ProfHindsight/Project-Temp-Sensor-Hardware/Requirements.docx

Requirements:

1. Monitor 1-4 temperature/humidity sensors
2. Bluetooth/802.15.4 device
3. Coin cell powered device
4. Low power consumption

Stretch Goals:

1. Micro USB powerable
2. 2.0V regulator for increased efficiency and 1.
3. External temperature sensor (for a freezer)
4. Buzzer/Speaker
5. Microphone
