ProfHindsight/Project-Temp-Sensor-Hardware/BOM.xlsx

Sheet: V1.0
Vanilla Board
Description | Part Number | Ref | Unit Cost | Quantity | Total | Quantity (x3)
Pressure Sensor | 828-1064-1-ND | IC3 | 3.48 | 1 | 3.48 | 3
Temp and Humidity Sensor | 336-3138-5-ND | IC2 | 2.6 | 1 | 2.6 | 3
Coin Cell Neg Contact | 36-2993-ND | H1 | 0.16 | 1 | 0.16 | 3
Coin Cell Retainer | BC-2003-ND | U1 | 0.33 | 1 | 0.33 | 3
Pushbutton | EG4620CT-ND | U2 | 0.19 | 1 | 0.19 | 3
Gecko MCU | 914-1032-1-ND | IC1 | 1.64 | 1 | 1.64 | 3
Small Decouple | 490-1318-1-ND | C3, C4, C5 | 0.1 | 3 | 0.3 | 9
Buzzer | 433-1027-ND | P5 | 0.59 | 1 | 0.59 | 3
NRF24L | NRF24L01 | P2 | 1.12 | 1 | 0.59 | 3
Decouple Cap | 490-1319-1-ND | C1, C2, C6, C7 | 0.1 | 4 | 0.4 | 12
I2C Resistors | 311-4.7KJRCT-ND | R1, R2 | 0.1 | 2 | 0.2 | 6
 |  |  |  |  | 0
Total |  |  |  |  | 10.48
 |  |  |  |  |  |  | `

Sheet: V2.0
USB Powerable
Description | Part Number | Ref | Unit Cost | Quantity | Total | Quantity (x3)
Pressure Sensor | 828-1064-1-ND | IC3 | 3.48 | 1 | 3.48 | 3
Temp and Humidity Sensor | 336-3138-5-ND | IC2 | 2.6 | 1 | 2.6 | 3
Coin Cell Neg Contact | 36-2993-ND | H1 | 0.16 | 1 | 0.16 | 3
Coin Cell Retainer | BC-2003-ND | U1 | 0.33 | 1 | 0.33 | 3
Micro USB Port | 609-4613-1-ND | P4 | 0.46 | 1 | 0.46 | 3
Ideal Diode | MAX40200AUK+TCT-ND | IC4 | 0.62 | 1 | 0.62 | 3
2.0V Regulator | 893-1172-1-ND | U3 | 1.24 | 1 | 1.24 | 3
Gecko MCU | 914-1092-1-ND | IC1 | 1.26 | 1 | 1.26 | 3
Small Decouple | 490-1318-1-ND | C3, C4, C5 | 0.1 | 3 | 0.3 | 9
2.0V Input Cap | 490-5915-1-ND | C8 | 0.16 | 1 | 0.16 | 3
2.0V Output Cap | 490-10693-1-ND | C9 | 0.13 | 1 | 0.13 | 3
Buzzer | 433-1027-ND | P5 | 0.59 | 1 | 0.59 | 3
Decouple Cap | 490-1319-1-ND | C1, C2, C6, C7 | 0.1 | 4 | 0.4 | 12
Feedforward Cap | 490-5951-1-ND | C10 | 0.1 | 1 | 0.1 | 3
10M Res | 311-10.0MLRCT-ND | R3 | 0.1 | 1 | 0.1 | 3
600k Res | YAG3192CT-ND | R4 | 0.1 | 1 | 0.1 | 3
400k Res | YAG3143CT-ND | R5 | 0.1 | 1 | 0.1 | 3
300k Res | YAG3108CT-ND | R6 | 0.1 | 1 | 0.1 | 3
200k Res | YAG3024CT-ND | R7 | 0.1 | 1 | 0.1 | 3
I2C Resistors | 311-4.7KJRCT-ND | R1, R2 | 0.1 | 2 | 0.2 | 6
NRF24L | NRF24L01 | P2 | 1.12 | 1 | 0.59 | 3
 |  |  |  |  | 0 | 0
Total |  |  |  |  | 13.12

Sheet: Daughterboard
Daughterboard
Description | Part Number | Ref | Unit Cost | Quantity | Total | Quantity (x3)
4-conductor ribbon cable | WM04-06A-ND |  | 0.66 | 1 | 0.66 | 3
 |  |  |  |  |  | 0
Total |  |  |  |  | 0.66
