ProfHindsight/Project-Temp-Sensor-Hardware/WirelessTempSensorV2.0/WirelessTempSensorV2.0.pdf

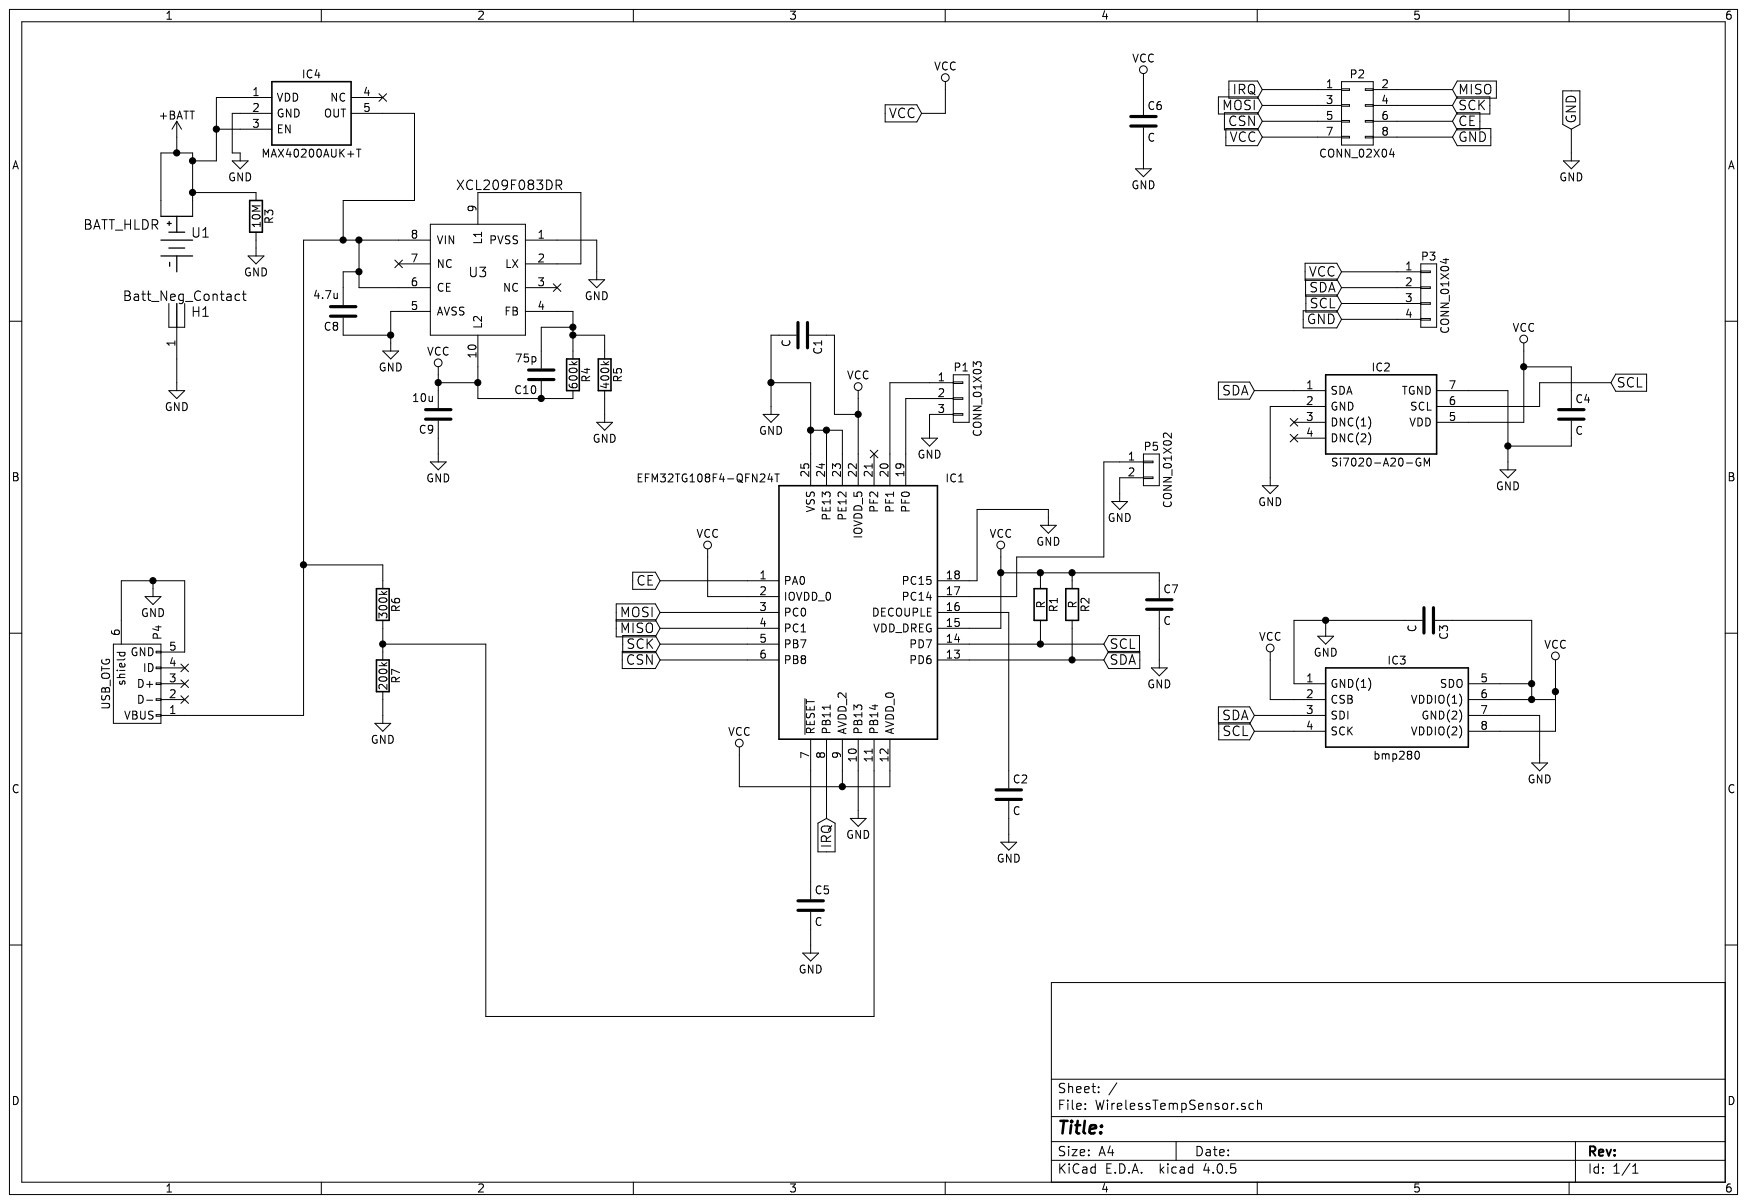
[picture p1: page 1]
