ProfHindsight/Project-Temp-Sensor-Hardware/WirelessTempSensorV1.0/WirelessTempSensorV1.0.pdf

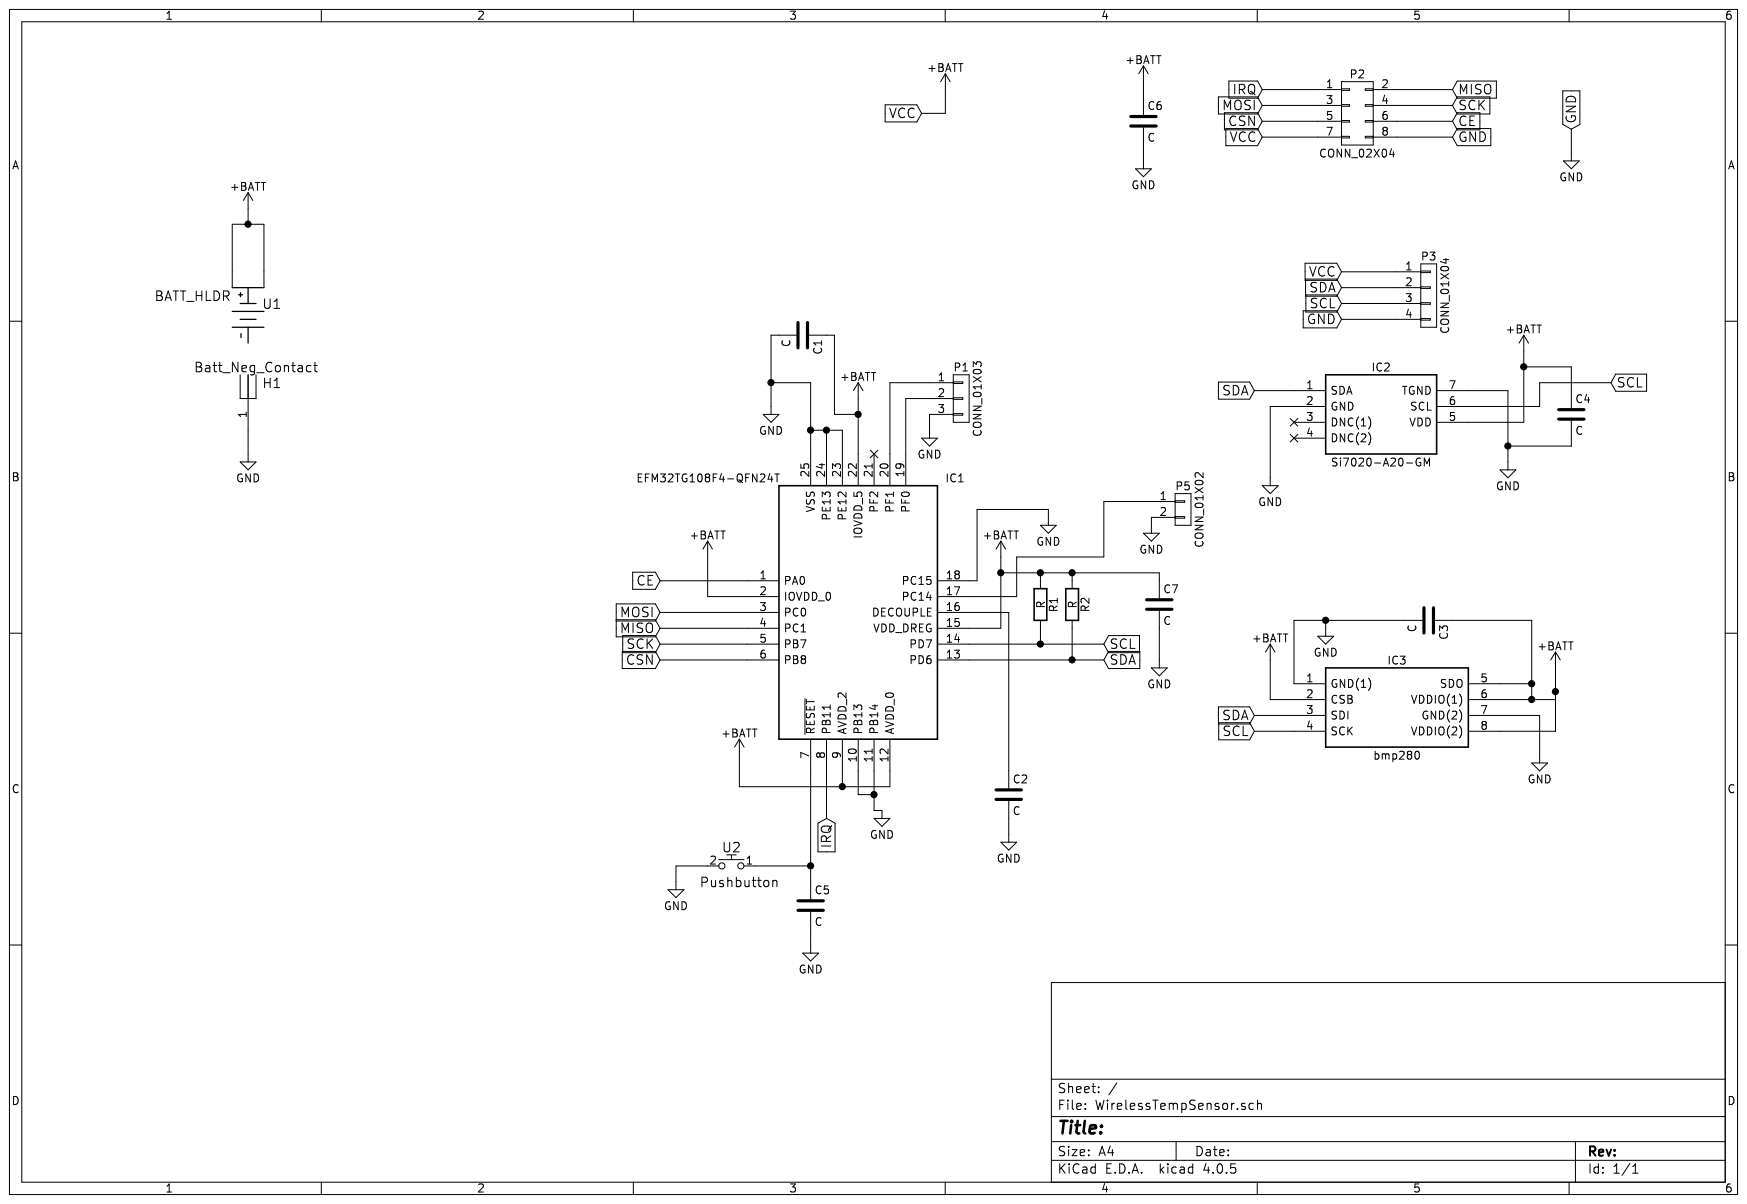
[picture p2: page 1]
