ProfHindsight/Project-Temp-Sensor-Hardware/WirelessTempSensorV1.0/WirelessTempSensor/WirelessTempSensor.kicad_pcb

## KiCad design WirelessTempSensorV1.0/WirelessTempSensor/WirelessTempSensor.kicad_pcb (2018-09-09, an earlier design)

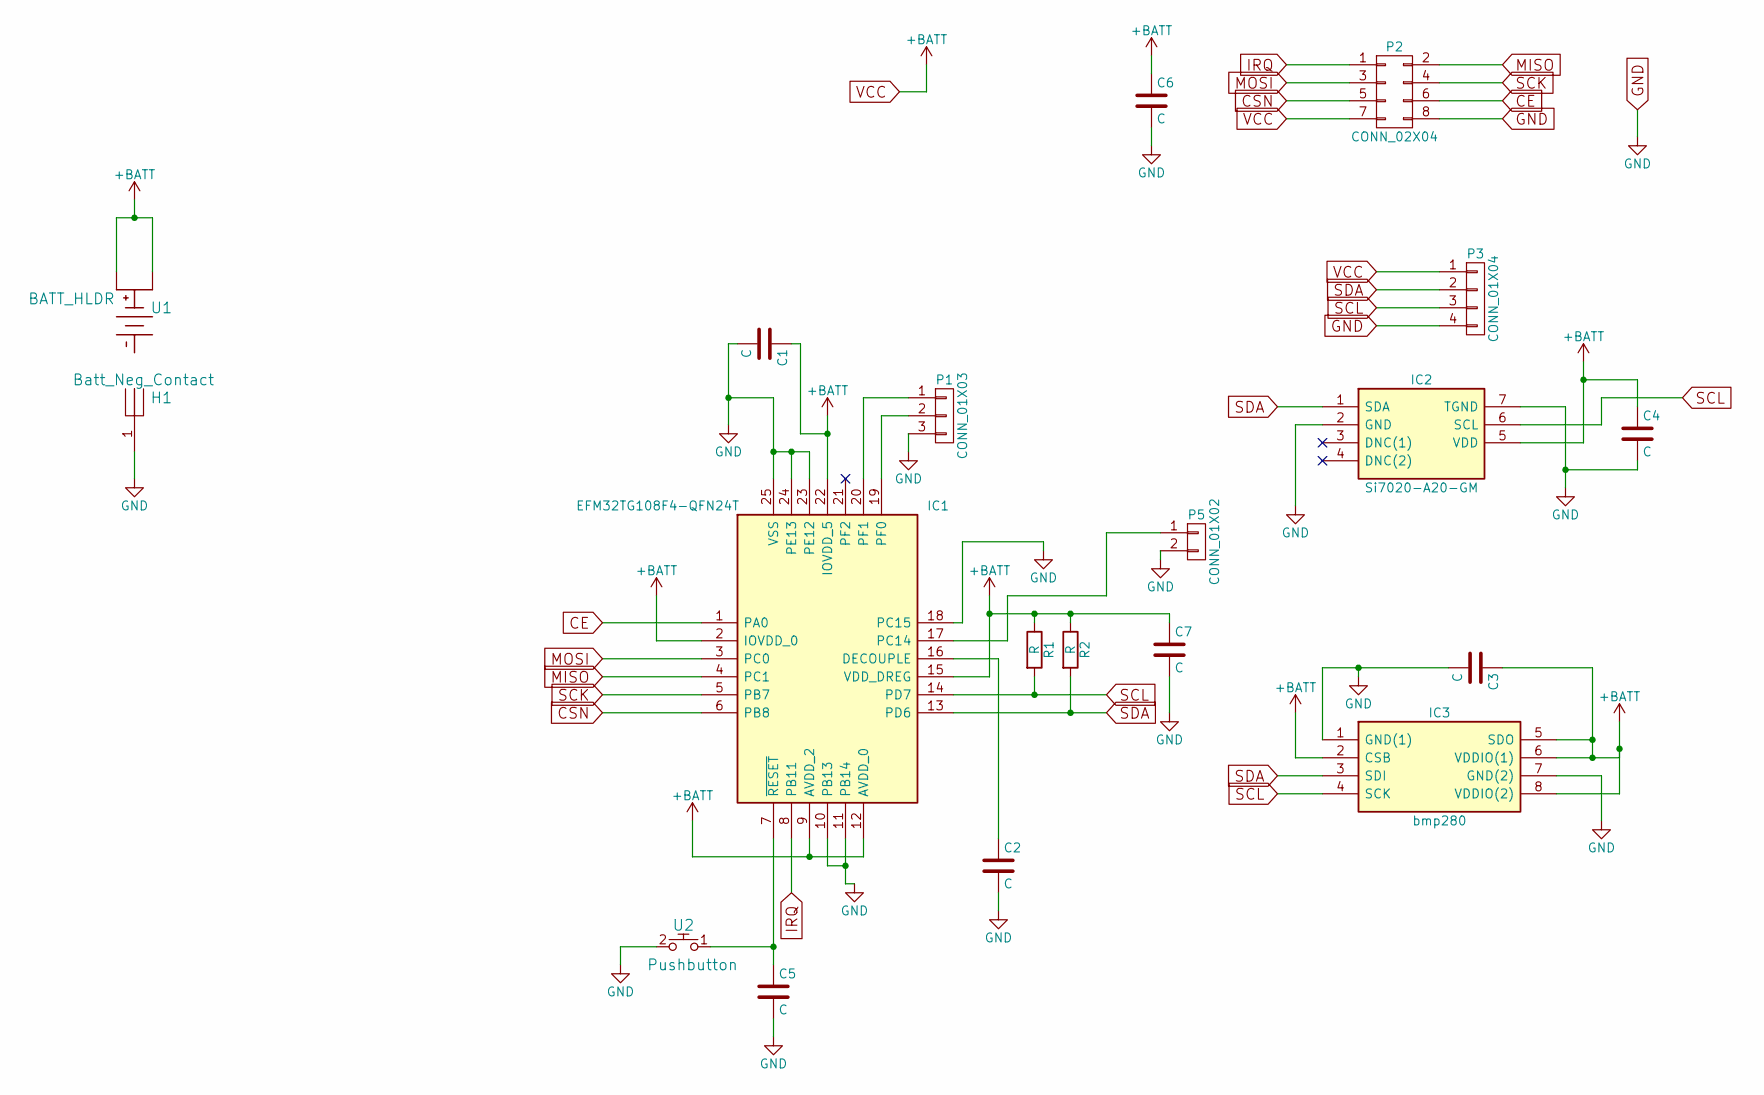
[picture p3: schematic WirelessTempSensor.sch]

Parts:
C1, C2, C3, C4, C5, C6, C7: C; C_0402
H1: Batt_Neg_Contact
IC1: EFM32TG108F4-QFN24T; QFN65P500X500X90-25N; Manufacturer_Part_Number EFM32TG108F4-QFN24T
IC2: Si7020-A20-GM; SON100P300X300X80-7N; Manufacturer_Part_Number Si7020-A20-GM
IC3: bmp280; 8-PIN-METAL-LID-LGA; Manufacturer_Part_Number bmp280
P1: CONN_01X03; Conn_1x3_SMD
P2: CONN_02X04; SDL-108-X-XX_2x04
P3: CONN_01X04; Conn_1x4_SMD
P5: CONN_01X02; Conn_1x2_SMD
R1, R2: R; R_0402
U1: BATT_HLDR; BAT-HLD-001
U2: Pushbutton; PB-P010336

Connections:
CE: IC1.1 (PA0), P2.6
CSN: IC1.6 (PB8), P2.5
GND: C1.2, C2.2, C3.2, C4.2, C5.2, C6.2, C7.2, H1.1, IC1.10 (PB13), IC1.11 (PB14), IC1.18 (PC15), IC1.23 (PE12), IC1.24 (PE13), IC1.25 (VSS), IC2.2 (GND), IC2.7 (TGND), IC3.1 (GND(1)), IC3.7 (GND(2)), P1.3, P2.8, P3.4, P5.2, U2.2
IRQ: IC1.8 (PB11), P2.1
MISO: IC1.4 (PC1), P2.2
MOSI: IC1.3 (PC0), P2.3
unnamed: C2.1, IC1.16 (DECOUPLE)
unnamed: C5.1, IC1.7 (~RESET), U2.1
unnamed: IC1.17 (PC14), P5.1
unnamed: IC1.19 (PF0), P1.2
unnamed: IC1.20 (PF1), P1.1
SCK: IC1.5 (PB7), P2.4
SCL: IC1.14 (PD7), IC2.6 (SCL), IC3.4 (SCK), P3.3, R1.2
SDA: IC1.13 (PD6), IC2.1 (SDA), IC3.3 (SDI), P3.2, R2.2
VCC: C1.1, C3.1, C4.1, C6.1, C7.1, IC1.2 (IOVDD_0), IC1.9 (AVDD_2), IC1.12 (AVDD_0), IC1.15 (VDD_DREG), IC1.22 (IOVDD_5), IC2.5 (VDD), IC3.2 (CSB), IC3.5 (SDO), IC3.6 (VDDIO(1)), IC3.8 (VDDIO(2)), P2.7, P3.1, R1.1, R2.1, U1.1, U1.3

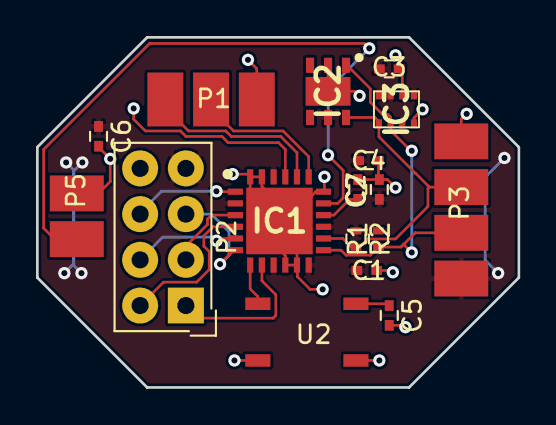
[picture p4: board WirelessTempSensorV1.0/WirelessTempSensor/WirelessTempSensor.kicad_pcb from above]

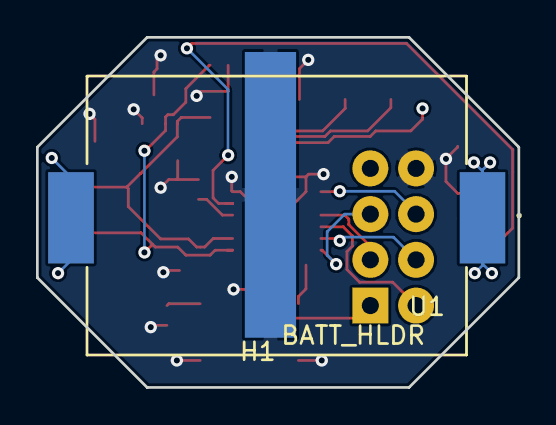
[picture p5: board WirelessTempSensorV1.0/WirelessTempSensor/WirelessTempSensor.kicad_pcb from below]

Board: 2 copper layers, 26.8 x 19.5 mm, 19 parts (2 on the bottom side), 15 nets.
