ProfHindsight/Project-Temp-Sensor-Hardware/WirelessTempSensorDaughterboardV1.0/WirelessTempSensor.kicad_pcb

## KiCad design WirelessTempSensorDaughterboardV1.0/WirelessTempSensor.kicad_pcb (2018-09-09)

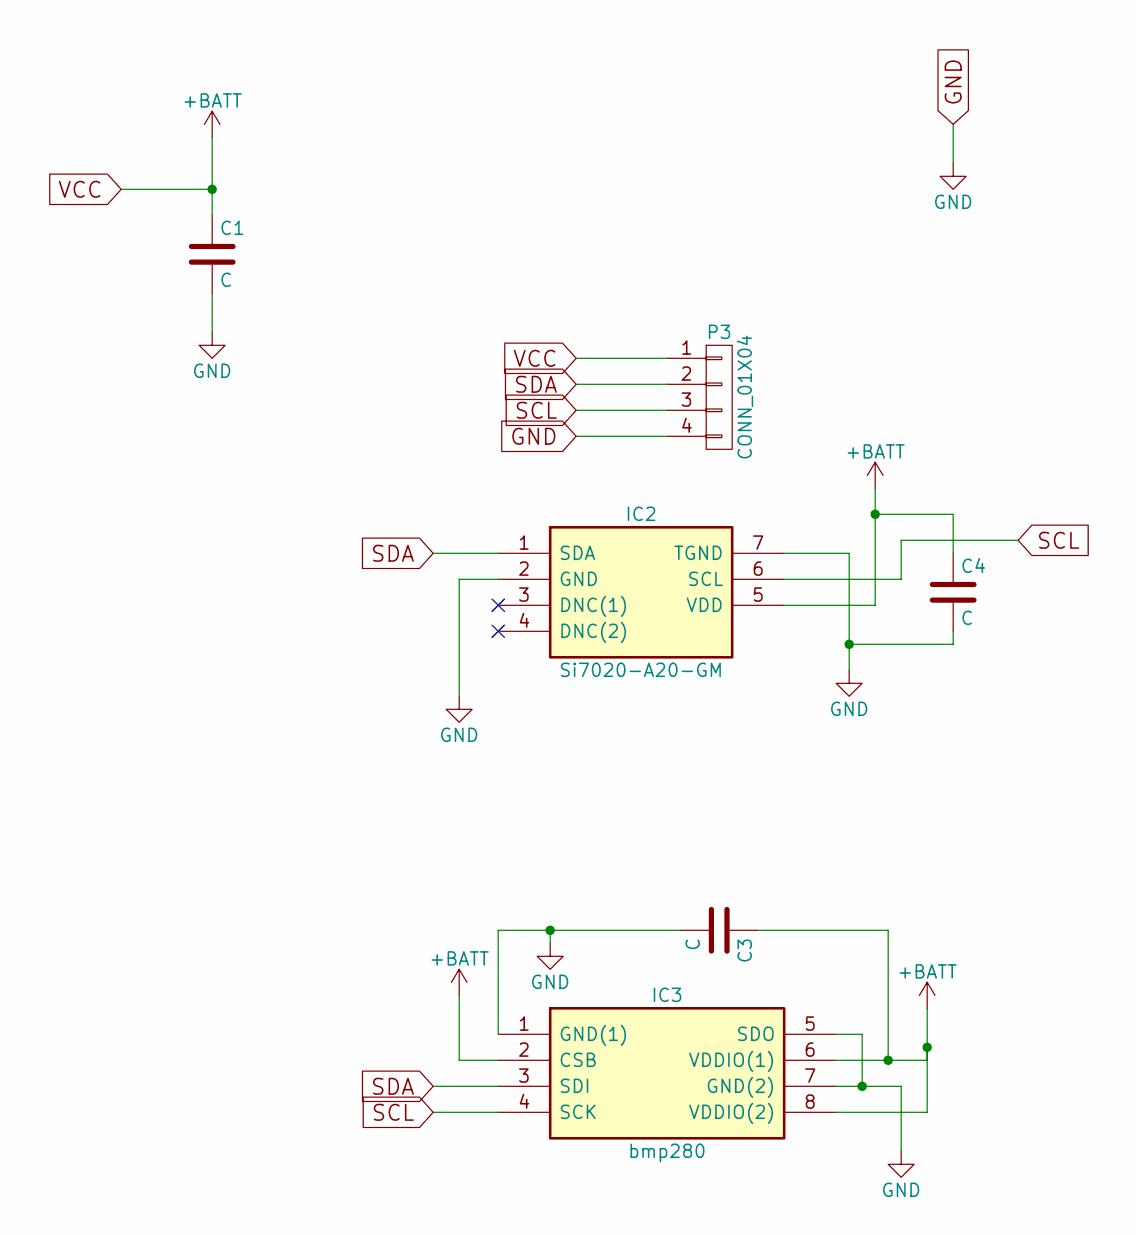
[picture p6: schematic WirelessTempSensor.sch]

Parts:
C1, C3, C4: C; C_0402
IC2: Si7020-A20-GM; SON100P300X300X80-7N; Manufacturer_Part_Number Si7020-A20-GM
IC3: bmp280; 8-PIN-METAL-LID-LGA; Manufacturer_Part_Number bmp280
P3: CONN_01X04; Conn_1x4_SMD

Connections:
GND: C1.2, C3.2, C4.2, IC2.2 (GND), IC2.7 (TGND), IC3.1 (GND(1)), IC3.5 (SDO), IC3.7 (GND(2)), P3.4
SCL: IC2.6 (SCL), IC3.4 (SCK), P3.3
SDA: IC2.1 (SDA), IC3.3 (SDI), P3.2
VCC: C1.1, C3.1, C4.1, IC2.5 (VDD), IC3.2 (CSB), IC3.6 (VDDIO(1)), IC3.8 (VDDIO(2)), P3.1

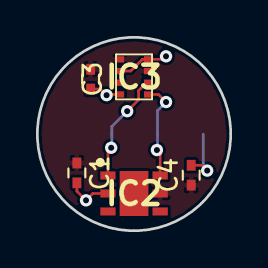
[picture p7: board WirelessTempSensorDaughterboardV1.0/WirelessTempSensor.kicad_pcb from above]

Board: 2 copper layers, 10.7 x 10.7 mm, 6 parts (1 on the bottom side), 4 nets.
