ProfHindsight/Project-Temp-Sensor-Hardware/Programming Instructions.docx

1. Follow the connection notes under “Connection Notes.docx”
2. Build the image for the specific hardware used.
  a. If using the custom board, define “CUSTOM_BOARD” in utilities.cpp
  b. You probably need to undefine “DEBUG” in utilities.cpp for the code to fit
  c. In main.cpp, define “HARDWARE_VERSION_X_X”
  d. Ensure the above step is recognized in “utilities.cpp”
  e. Some of the defines may be located under “Project -> Properties -> C/C++ Build -> Settings”. Be sure to check there and play around with whatever option works best.
3. Once the bootloader is up, type “u” to upload
4. Send the .bin file with XMODEM. Using Tera Term,
  a. File -> Transfer -> XModem -> Send…
