ProfHindsight/Project-Temp-Sensor-Hardware/(commit log)

2018-09-09 Adding initial files
    [BOM.xlsx, BOMDaughterboard.xlsx, BOMV1.xlsx, BOMV2.xlsx, CombinedBOM.xlsx, TG-QFN24.csv, WirelessTempSensor.kicad_pcb, WirelessTempSensor.sch]
2018-10-02 Generating binaries
    [datafile.csv]
